rovwfcho/claude-i-suppose.../checks/owner_photos/battery_length.jpg

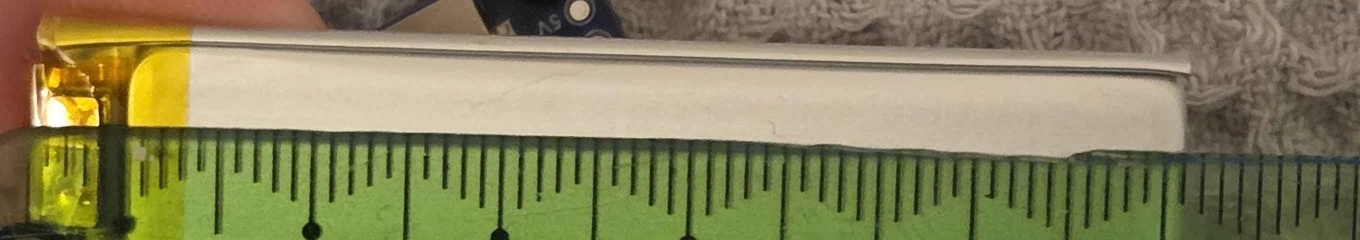
checks/owner_photos/battery_length.jpg
