rovwfcho/claude-i-suppose.../checks/owner_photos/battery_thickness.jpg

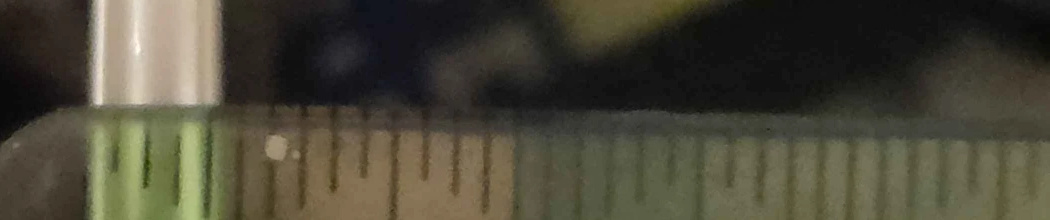
checks/owner_photos/battery_thickness.jpg
