rovwfcho/claude-i-suppose.../checks/owner_photos/battery_width.jpg

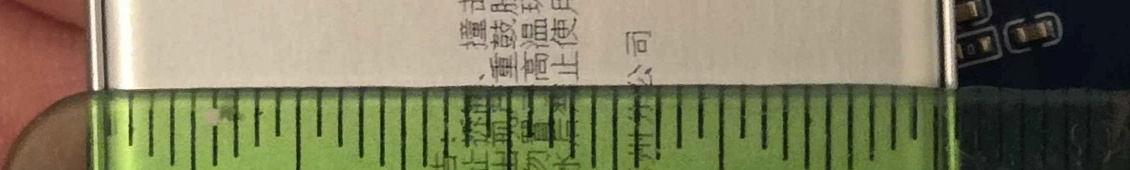
checks/owner_photos/battery_width.jpg
