rovwfcho/claude-i-suppose.../checks/owner_photos/board_back.jpg

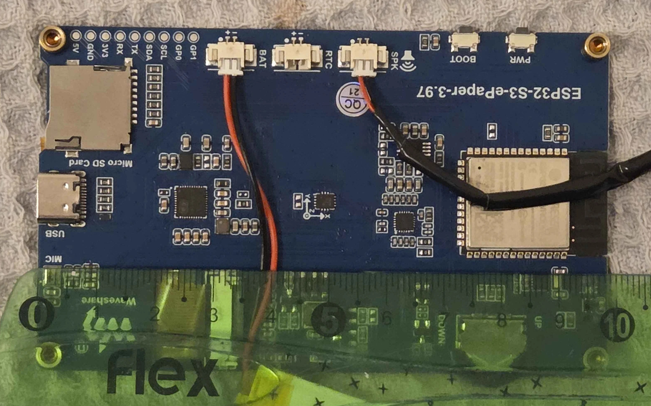
checks/owner_photos/board_back.jpg
