rovwfcho/claude-i-suppose.../checks/owner_photos/front_across_a.jpg

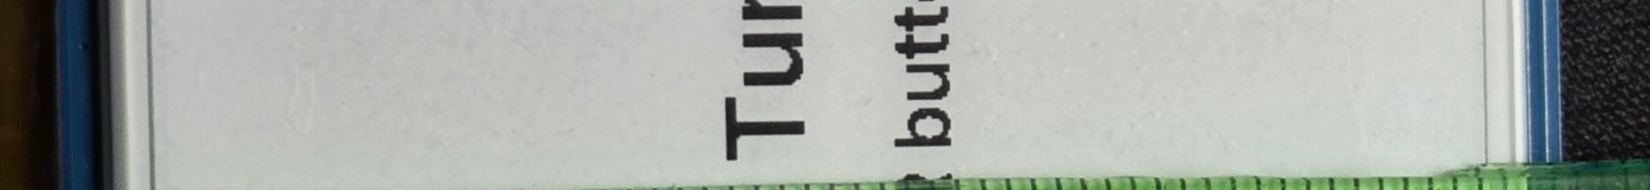
checks/owner_photos/front_across_a.jpg
