rovwfcho/claude-i-suppose.../checks/owner_photos/front_across_b.jpg

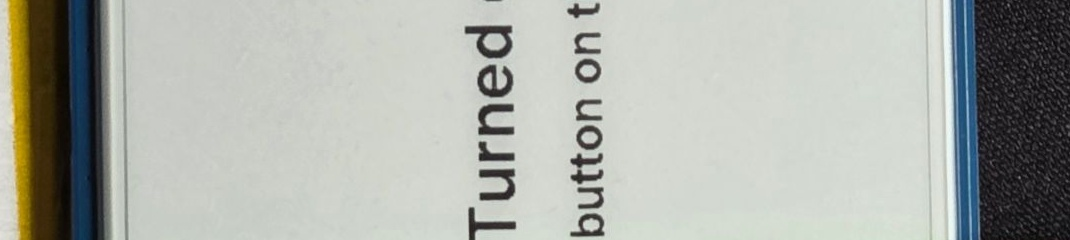
checks/owner_photos/front_across_b.jpg
