rovwfcho/claude-i-suppose.../checks/owner_photos/front_long.jpg

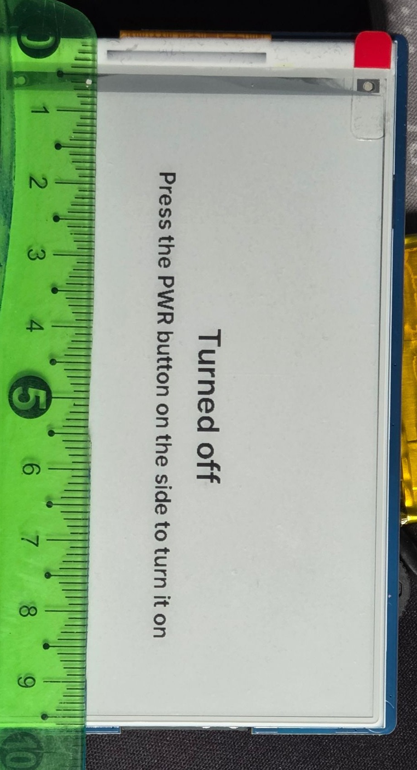
checks/owner_photos/front_long.jpg
