rovwfcho/claude-i-suppose.../checks/owner_photos/speaker_face.jpg

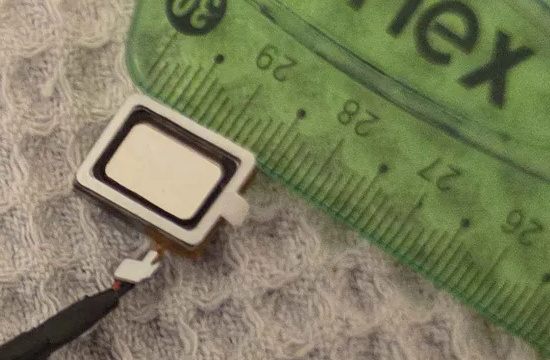
checks/owner_photos/speaker_face.jpg
