rovwfcho/claude-i-suppose.../checks/owner_photos/speaker_length.jpg

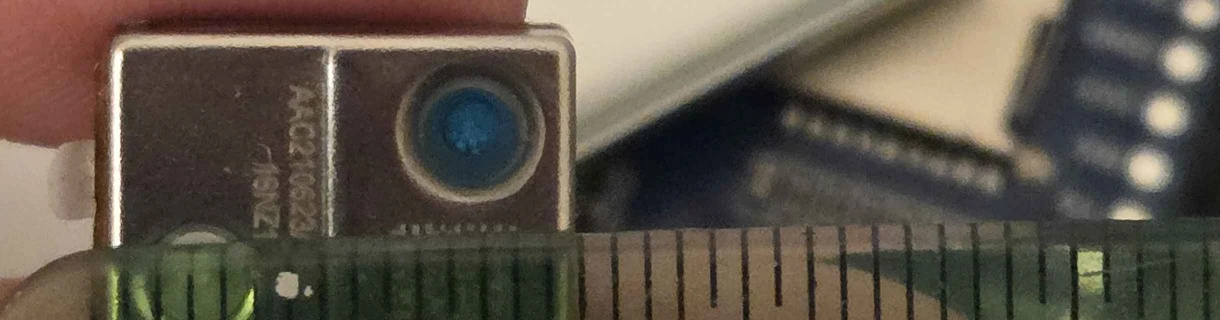
checks/owner_photos/speaker_length.jpg
