rovwfcho/claude-i-suppose.../checks/owner_photos/speaker_thickness.jpg

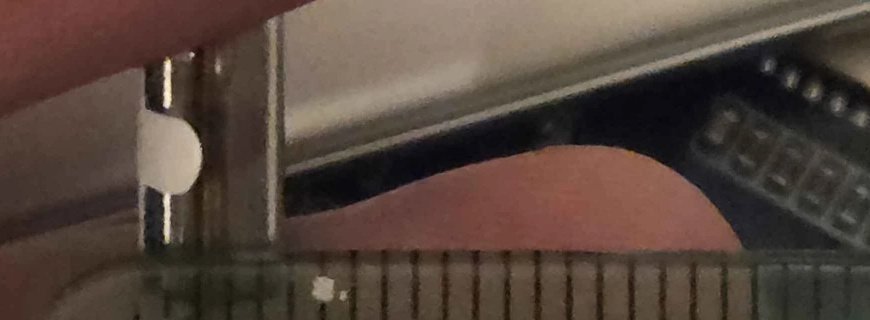
checks/owner_photos/speaker_thickness.jpg
