rovwfcho/claude-i-suppose.../checks/owner_photos/speaker_width.jpg

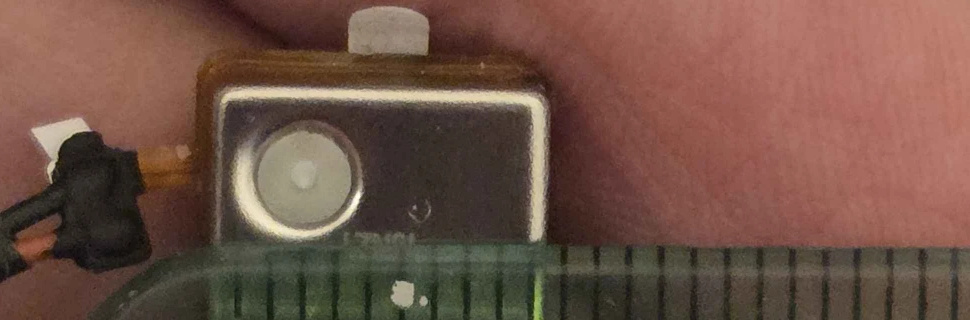
checks/owner_photos/speaker_width.jpg
