rovwfcho/claude-i-suppose.../preview/checks_sections_battery.png

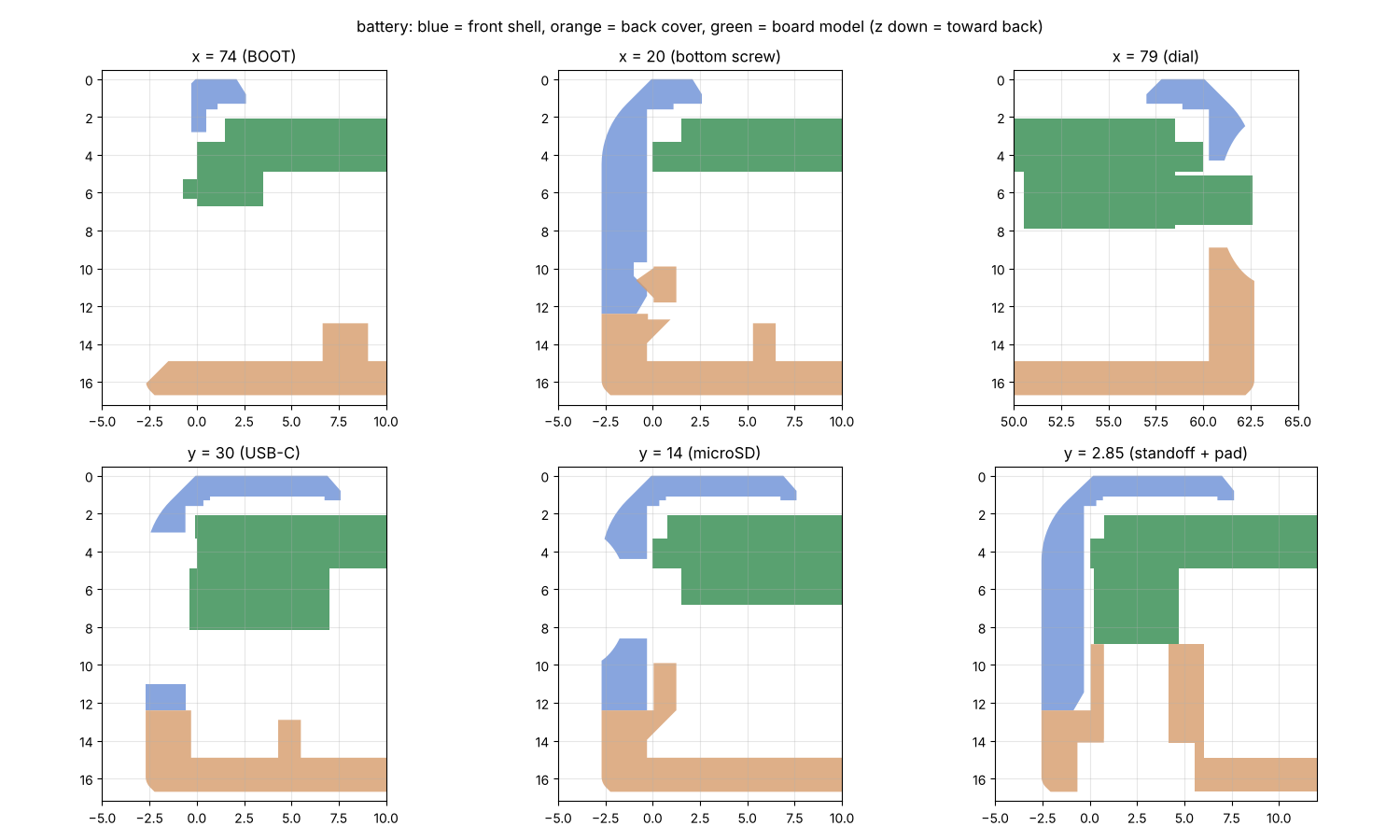
preview/checks_sections_battery.png
