rovwfcho/claude-i-suppose.../preview/screw_locations.png

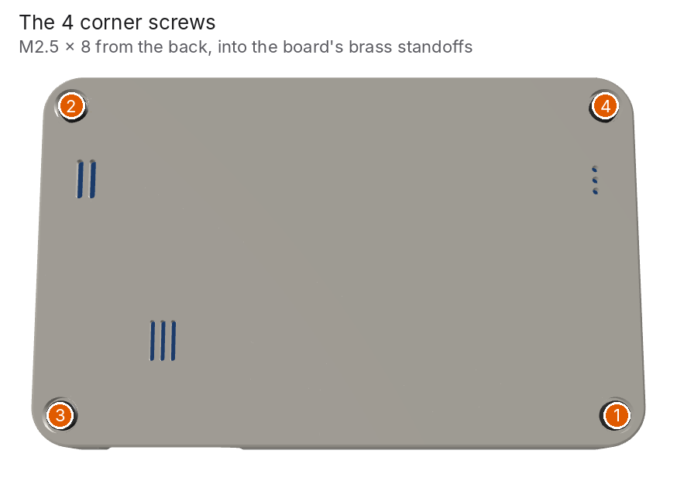
preview/screw_locations.png
