rovwfcho/claude-i-suppose.../preview/section_battery.png

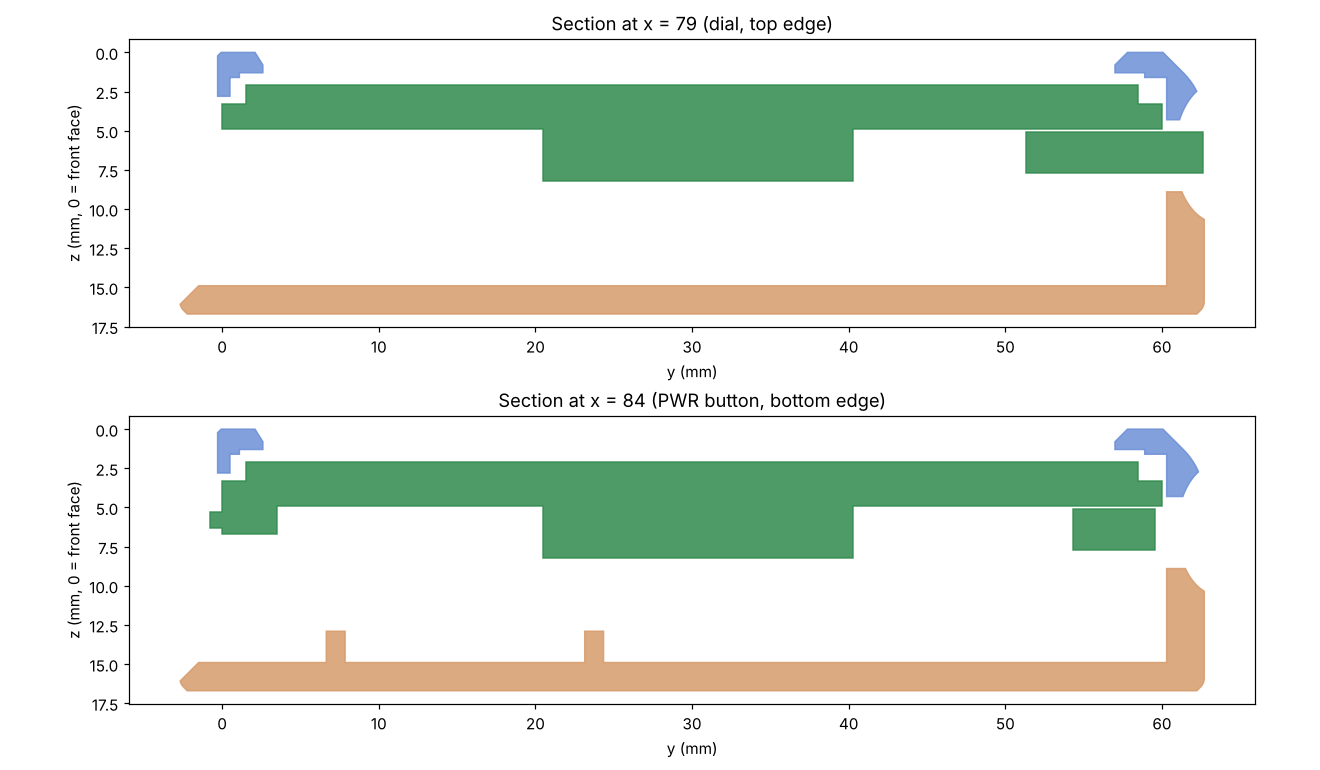
preview/section_battery.png
