rovwfcho/claude-i-suppose.../stl/front_shell_battery.stl

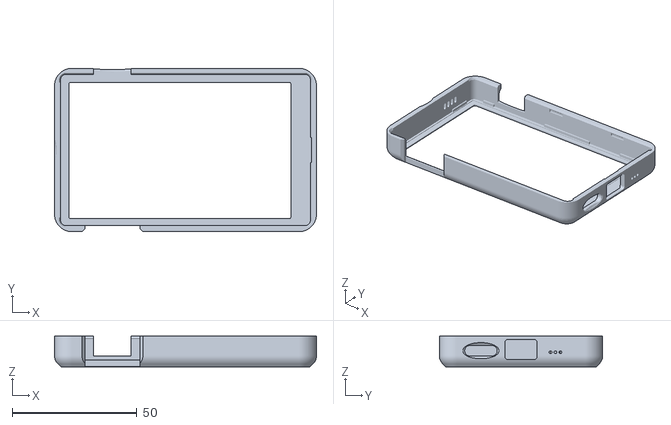
[picture p17: CAD file, 2026-11-04]
stl/front_shell_battery.stl
104.9 x 65.4 x 12.4
