rovwfcho/claude-i-suppose.../stl/back_cover_battery.stl

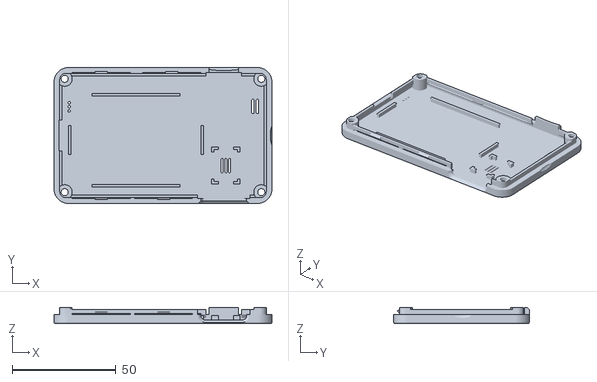
[picture p18: CAD file, 2026-11-03]
stl/back_cover_battery.stl
104.9 x 65.4 x 7.80
