rovwfcho/claude-i-suppose.../preview/owner_measurements.png

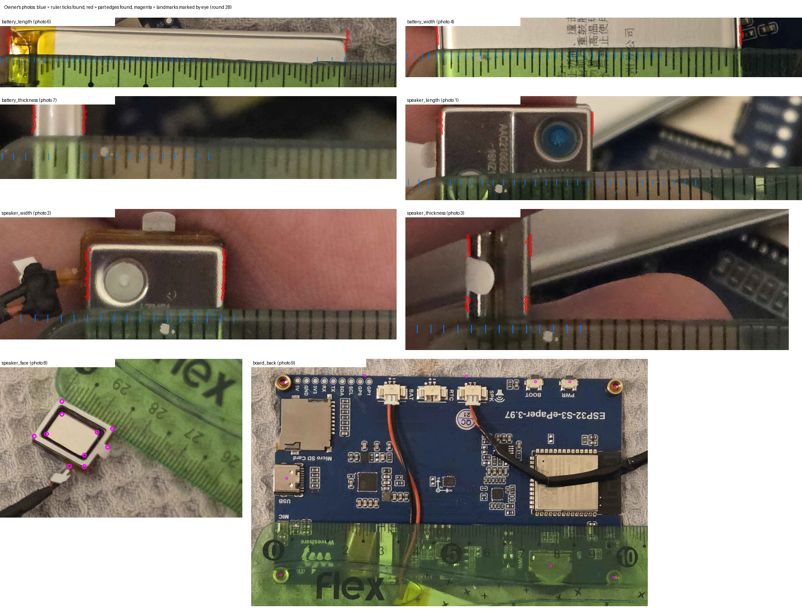
preview/owner_measurements.png
