rovwfcho/claude-i-suppose.../(commit log)

2026-11-02 Case as delivered in session 3 (PETG, Waveshare's battery and speaker estimates)
    Imported unchanged from esp32-s3-epaper-3.97-case-source.zip, as the base
    for the changes that follow.
    Claude-Session: https://claude.ai/code/session_01RzvsLZ87ThsvwoT6kJV15S
    [back_cover_battery.stl, front_shell_battery.stl]
2026-11-02 Fit the owner's measured battery and speaker; PLA
    Battery bay 62.5 x 42.5 mm with guides on all four sides for the measured
    61.1 x 40.8 x 4.3 mm cell. Speaker pocket 11.2 x 15.3 mm with corner
    brackets for the measured 14.2 x 10.2 x 4.5 mm speaker, grille as three
    slots under its membrane. 1.8 mm screw pilots for PLA. Wire routes and a
    loop for the spare speaker cable. Round 28 measures the parts from the
    owner's photos; README, guides, renders and zip rebuilt.
    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
    [back_cover_battery.stl]
2026-11-02 Rounds J and 29: gentler cable routes, bigger cable loop, corrected numbers
    Speaker cable route slopes down under the battery (bends of 3 mm or more),
    battery wire bends of at least 1 mm, spare-cable loop holds about 77 mm.
    Battery width 40.7 mm as measured. Round 29 adds a tolerance stack-up,
    ID pictures of the guide, cross-document numbers, cable bend radii,
    calipers and a heat estimate. Check fixes in rounds 17 and 20.
    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
2026-11-02 Round 30: speaker handedness, traced cable lengths, slicer coverage, clean-clone docs
    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
2026-11-02 Round 30 fixes (README wording, traced cable lengths) and round 31
    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
2026-11-02 Round 31 fixes: turn the cover over along the bottom edge, pre-cut threads in step 4
    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
2026-11-02 Round 32: G-code calipers, assembly order, grille acoustics
    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
2026-11-02 Round 33: slots 0.9 mm (0.9 mm webs), cable antenna keep-out check, guide parity, mutation tests
    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
    [back_cover_battery.stl]
2026-11-02 Round 34: volume accounting, picture references, battery plausibility
    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
2026-11-03 WIP: board screwed to the back through its corner standoffs, snap-on front lid
    Work in progress, not yet fully checked:
    - case.py: 4 corner posts on the back cover (3.4 mm holes, 6.0 x 1.8 mm flush
    recesses, posts end where a 4 mm standoff ends, so an M2.5 x 8 goes 2 mm in);
    side screws, screw blocks and foam rings removed; 4 in-plane snap clips in the
    skirt with grooves in the lid; back edge round 1 mm; glass relief, pads 0.3 mm
    off the PCB; USB-C and microSD openings 1 mm taller for 3 mm standoffs;
    standoff positions re-estimated from the owner's photo.
    - verify.py and rounds 1-11, 17, 22, 23, 31, 34 adapted; new round 35 and the
    caching runner checks/run_checks.py (not yet run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
    [back_cover_battery.stl, front_shell_battery.stl]
2026-11-03 Recess bridging layers, checks and docs for the corner screws and clips; guides, renders and zip rebuilt
    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
    [back_cover_battery.stl]
2026-11-03 Clips: 27 mm beams, 0.55 mm undercut (print-error tolerant); posts rounder at the corners; rounds 35-36
    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
    [back_cover_battery.stl, front_shell_battery.stl]
2026-11-03 Round 37: log numbers, assembly slips in all three documents, Markdown
    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
2026-11-03 Rounds 35-38: recess 6.2 mm, back edge 0.8 mm, clips 28 mm, pads 0.5 mm, glass 0.8 mm; checks and log
    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
    [back_cover_battery.stl, front_shell_battery.stl]
2026-11-03 Rounds 39-40: assembly in the guides' order, lid as sliced, forces from the meshes, terminology, lying flat
    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
2026-11-03 Round 41: case.py comments recomputed, heat and cold; README corrections from the read-through
    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
2026-11-03 WIP round 44: front photo measured, window widened 0.7 mm to the left (7.7-96.4); explained.png generator
    Not yet done: guides/renders/zip rebuild (build_all.sh, make_zips.py) and the check runs on this geometry.
    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
    [front_shell_battery.stl]
2026-11-03 Round 45: light field across the board from photos 11-12, window down to y 2.9; window as sliced; tail relief 6.8; round 2 uses the drawing's active area; 400k auto-compact setting
    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
    [front_shell_battery.stl]
2026-11-03 Round 45: window corners 0.5 mm round so they cover the light field's; corner check
    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
    [front_shell_battery.stl]
2026-11-03 Round 45: pan heads only, fingertip-tight (clamp measured on the STL); bottom pad along the button opening stiffens the lip; round 5 measures the lip section
    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
    [front_shell_battery.stl]
2026-11-03 Round 45 read-through: guides' standoff accuracy wording; README pad note; round 46 script
    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
2026-11-03 Round 4: expect the README's pan-head screw wording
    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
2026-11-03 Reviewer fixes: 2.4 mm recesses for 2.1 mm pan heads, clip slots 0.3 mm into the rim, ESP32 module and antenna from the back photo, assembly wording, stale overlay removed; round 46 sliced air-gap ch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
    [back_cover_battery.stl]
2026-11-03 Tallest head 2.0 mm (DIN 7985; ISO 7045 is lower); clip-end stubs measured and named in the README
    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
2026-11-03 Round 46: log the review fixes; rounds 38/39 limits, README overlay mention, guides' screw-length wording
    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
2026-11-03 Round 47: connectors from the owner's photo, wire routes to the plug faces, page-turn and open-reach checks on the STLs
    The board model's BAT/RTC headers were 2.2 mm too near the bottom edge and
    SPK was missing. All three now come from the back photo, with the plugs in
    BAT and SPK. Routes end at the plug faces: about 34 and 27 mm. README and
    both guides updated. New round 47 checks the assembly steps on the meshes.
    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
2026-11-04 Rounds 48-49: guides side by side, first-layer squish, window sized for the board's play
    Round 48: English/Bulgarian guide parity and first-layer squish checks;
    the Bulgarian buy list now warns against button heads by name.
    Round 49: the window is checked with the board anywhere the lid lets it
    sit. It now runs x 7.5-96.4, y 2.6-57.0 (88.9 x 54.4 mm), with narrower
    chamfers on the left and bottom edges so the frame's front face is
    unchanged. True first-layer width and download-zip checks added.
    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
    [front_shell_battery.stl]
2026-11-04 Round 49: right pads clear of the glass with the board's play, stale SPK box removed, battery wire wording
    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
    [front_shell_battery.stl]
2026-11-04 Round 50 fixes: window from x 7.6 (web to the tail relief 0.85 mm), checks updated; round 51 checks
    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
    [front_shell_battery.stl]
2026-11-04 Round 51 and 52: speaker note for lying on its back, guide layout checks
    - README and both guides now say the speaker sounds muffled with the case on its back.
    - Round 52: window Monte Carlo over 200 000 builds, README window numbers from the STL,
    every guide text in the PDFs, and the guide pages' print layout.
    - Step 2 picture: marker 6 moved along the battery wire so it no longer touches marker 3.
    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
2026-11-04 Round 53: stand it on its bottom edge; window across 0-50 C; guide print resolution
    - The speaker advice now names the bottom edge: on its top edge the case would rest on the dial.
    - Round 53 checks how the case stands on each face, the window margins from 0 to 50 C,
    and the guides' pictures at their printed size.
    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
2026-11-04 Round 54: mutation tests for rounds 44-53, guide page breaks; round 11 allows for board play
    - Round 54 makes 16 deliberate mistakes in a copy (design, README, guides) and checks that
    the newest checks catch each one, after a control run on the unchanged copy.
    - Round 54 also checks the guides' page breaks: no heading ends a page, every legend is whole
    and on its picture's page.
    - Round 11's table test now allows for the board's 0.3 mm play and, for the top edge, asks the
    README to warn (the dial reaches the top face).
    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
2026-11-04 Round 55: wrong-way-round assembly, guide pages by eye, log read-through 51-54
    - The board turned round or over, and the back cover turned round, all run into the lid,
    so none can be closed unnoticed; the right way round overlaps nothing.
    - The log now corrects round 52's Bulgarian line count (329 since round 53's tip).
    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
2026-11-04 Round 58: fixes from the independent review
    - Screw picture numbered in the guide's cross order (case.SCREW_ORDER)
    - README: USB-C grip up to 12.3 x 6.5 mm, stub 2.5 mm, 28 mm bridges
    with a post-print check, wording fixes
    - Window corners 0.4 mm round, so the light field keeps 0.1 mm with the
    board anywhere in its 0.3 mm play circle; round 49 now uses the circle
    - Steps: peel the display film, push the wires inside the rim before
    closing, "the end opposite the USB-C port", tuck the spare battery wire
    - round58.py: screw pictures agree, USB-C grip with the board's play,
    window cut from the lid's STL; round 37 looks for the new steps;
    round 46 measures the stubs at 0.01 mm
    Co-Autho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
    [front_shell_battery.stl]
2026-11-04 Rounds 59 and 60: new checks (in progress)
    - round59.py: every guide marker on the part its legend names; direction
    words read in each step's view; the round 58 reviewer's own scripts
    (kept in checks/review58/) re-run on the case
    - round60.py: every README number traced to the checks' output or worked
    out by hand
    - run_checks.py keeps each round's last output in checks/.cache/out/
    - run_all.sh and DEBUG_LOG.md list rounds 59 and 60 (entries to follow)
    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
